yislenierm/vehicle-eme-ecu/base-project/6 - Documentation _ Calculators/Efficiency Curve/Efficiency Curve Test.jpg

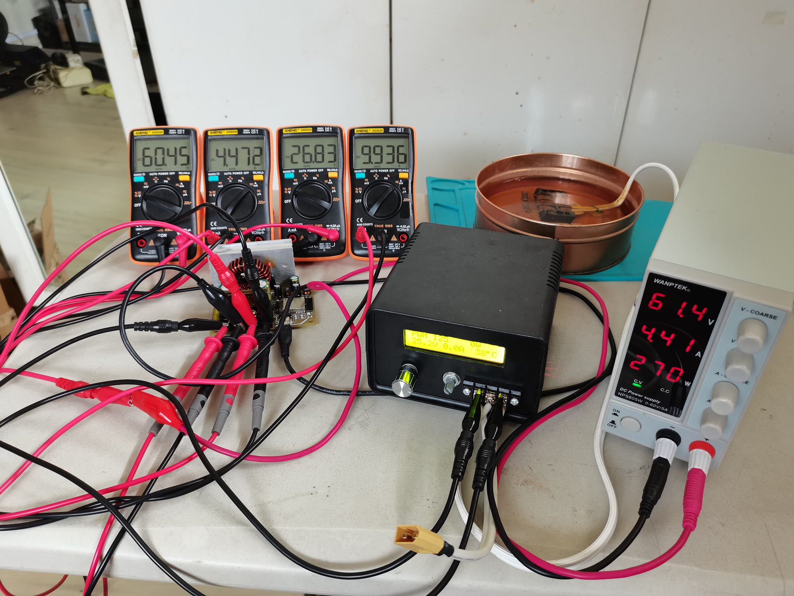
base-project/6 - Documentation _ Calculators/Efficiency Curve/Efficiency Curve Test.jpg
