yislenierm/vehicle-eme-ecu/README.md

# vehicle-eme-ecu
Vehicle/Boat Energy Management ECU

https://docs.google.com/document/d/18eBDC30Tg80u4Z4UTiznlT_HdNhbJPOtIIfXVYvO1t4/edit
