yislenierm/vehicle-eme-ecu/base-project/3 - Arduino ESP32 Code (Firmware)/Arduino Libraries/Read Me.txt

Copy, paste and replace the library folder with the attatched library folder on your Arduino IDE's System folder. 
Contact me at casithebuilder@gmail.com for concerns. Thank you!
