yislenierm/vehicle-eme-ecu/base-project/6 - Documentation _ Calculators/Reading Resources/ADS1115.docx

ADS1115

BIT VS. FREQUENCY LIMIT

8 bit - 31.25 kHz

9 bit - 15.625 kHz

10 bit - 78.125 kHz

11 bit - 39.0625 kHz

12 bit - 19.53125 kHz

ADC VALUES:

16 bit ADC - 65536
