yislenierm/vehicle-eme-ecu/base-project/6 - Documentation _ Calculators/Reading Resources/MPPT V3.docx

MPPT V3.0

BLYNK APP CONFIG

LABEL NAME | ITEM | BLYNK PIN | DESCRIPTION
SOLAR POWER (W) | GUAGE | V1
BATTERY PERCENTAGE (%) | GUAGE | V2
VOLTAGE (SOLAR) | LABELED VALUE | V3
CURRENT (SOLAR) | LABELED VALUE | V4
VOLTAGE (BATTERY) | LABELED VALUE | V5
CURRENT (BATTERY) | LABELED VALUE | V6
TEMPERATURE | LABELED VALUE | V7
ENERGY (KWH) | LABELED VALUE | V8
ENERGY SAVINGS (PESO) | LABELED VALUE | V9
CHG | LED | V10
FULL | LED | V11
ACT | LED | V12
FAULT | LED | V13
