yislenierm/vehicle-eme-ecu/base-project/1 - Schematic Files/2 - Button Breakout Board Schematic.png

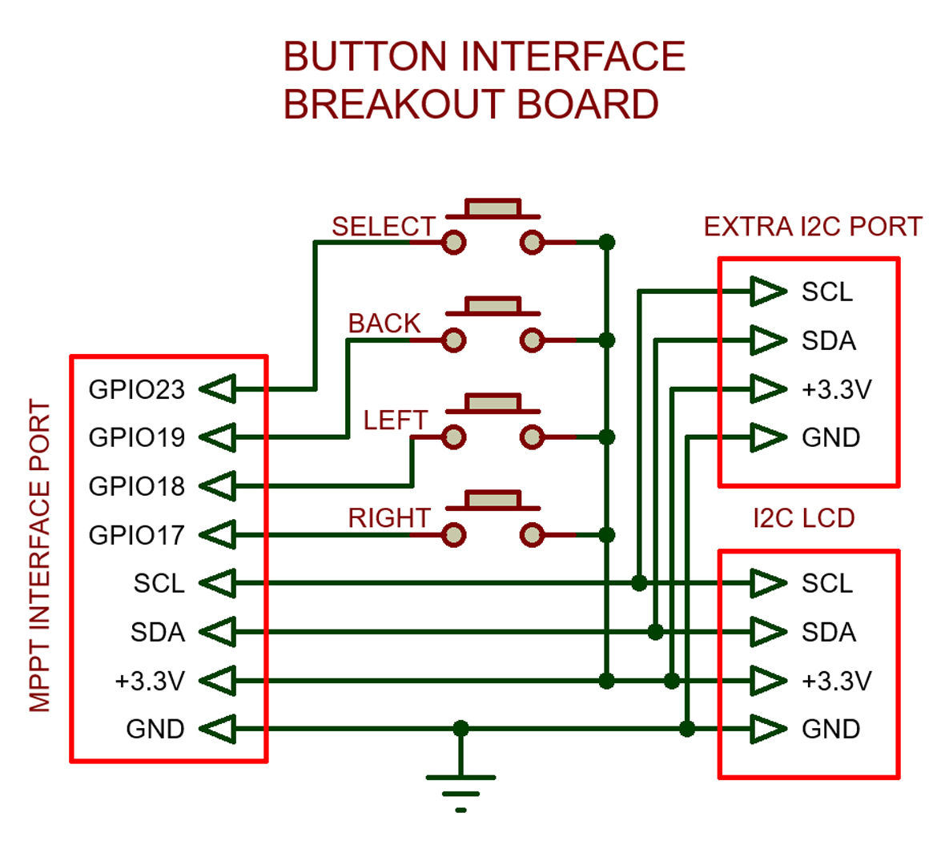
base-project/1 - Schematic Files/2 - Button Breakout Board Schematic.png
