yislenierm/vehicle-eme-ecu/base-project/1 - Schematic Files/3 - Two Pin Fan Breakout Board Schematic.png

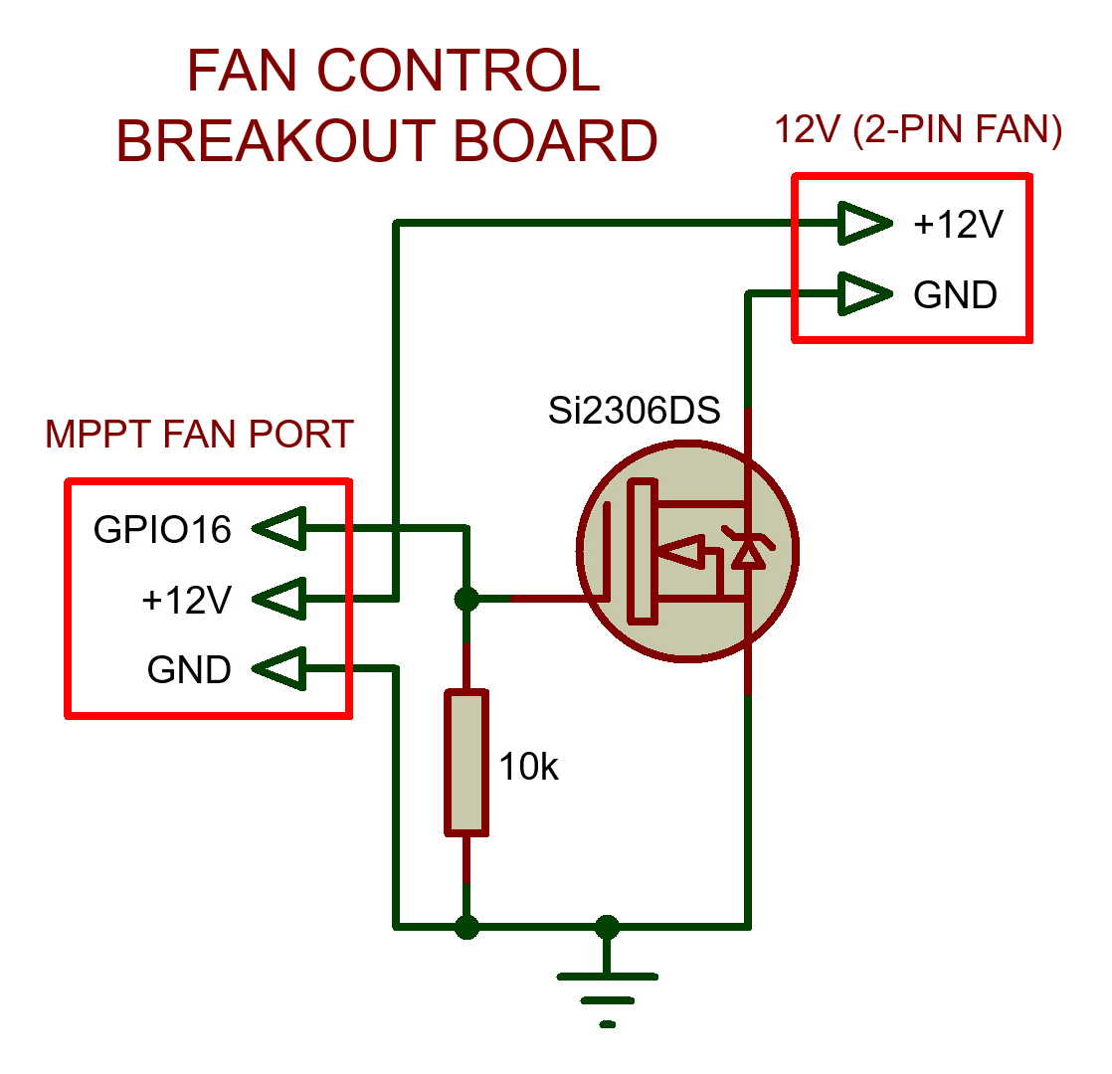
base-project/1 - Schematic Files/3 - Two Pin Fan Breakout Board Schematic.png
