yislenierm/vehicle-eme-ecu/base-project/6 - Documentation _ Calculators/Reading Resources/BACKFLOW GOLDEN SOLUTION.png

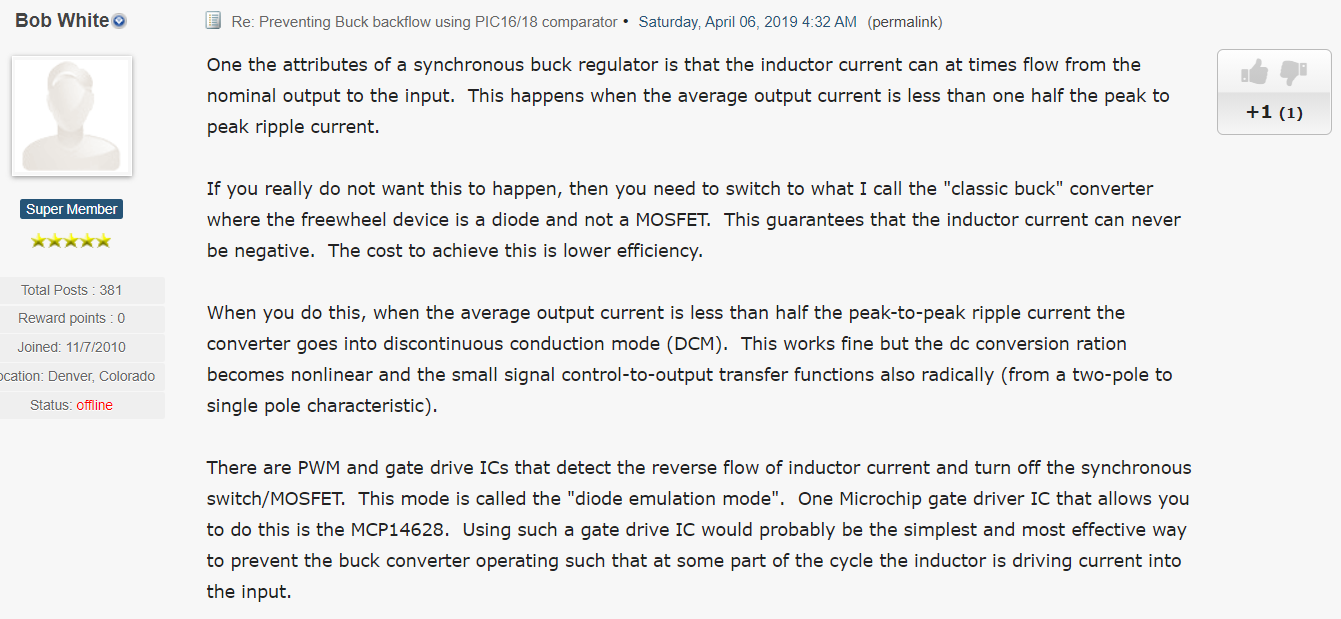
base-project/6 - Documentation _ Calculators/Reading Resources/BACKFLOW GOLDEN SOLUTION.png
