yislenierm/vehicle-eme-ecu/base-project/8 - Datasheets/Other References/INDUCTOR CORE - 0077071A7.jpg

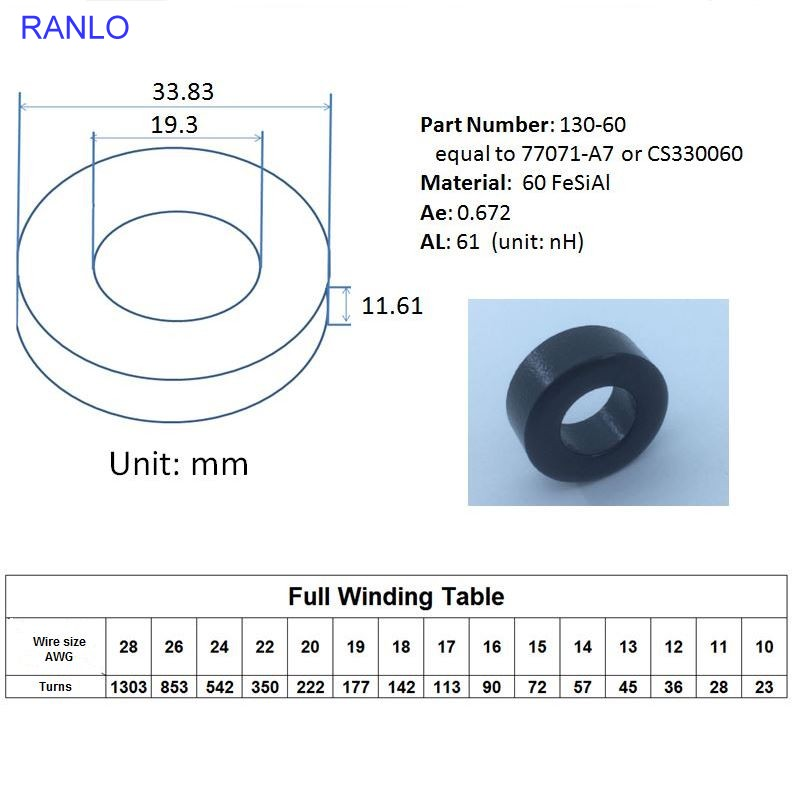
base-project/8 - Datasheets/Other References/INDUCTOR CORE - 0077071A7.jpg
