yislenierm/vehicle-eme-ecu/base-project/2 - PCB Files/Parts List.xlsx

PART# | TYPE | VALUE | SPECS | PACKAGE | Brand | DESCRIPTION | Cheapest Price (PHP) | Cheapest Price (USD) | Link (Where I Bought) | Link (Global) | Link (LCSC) | Link (RS Components) | Link (Digikey) | Link (Mouser)
Q1 | N-Channel MOSFET | CSD19505 | 80V, 208A, 2.6mΩ | TO220 | Texas Instruments |  | 15.3 | 0.306 | https://shopee.ph/10pcs-lot-CSD19505KCS-CSD19505-19505KCS-TO-220-80V-150A-new-original-In-Stock-i.409886423.4893377977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 | ! | ! | ! | ! | !
Q2 | N-Channel MOSFET | CSD19505 | 80V, 208A, 2.6mΩ | TO220 | Texas Instruments |  | 15.3 | 0.306 | https://shopee.ph/10pcs-lot-CSD19505KCS-CSD19505-19505KCS-TO-220-80V-150A-new-original-In-Stock-i.409886423.4893377977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 | ! | ! | ! | ! | !
Q3 | N-Channel MOSFET | CSD19505 | 80V, 208A, 2.6mΩ | TO220 | Texas Instruments |  | 15.3 | 0.306 | https://shopee.ph/10pcs-lot-CSD19505KCS-CSD19505-19505KCS-TO-220-80V-150A-new-original-In-Stock-i.409886423.4893377977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 | ! | ! | ! | ! | !
Q4 | N-Channel MOSFET | Si2306DS (A6SHB) | 30V, 2.8A, 94mΩ | SOT23 | Vishay |  | 1.66 | 0.0332 | https://shopee.ph/50pcs-SI2306DS-SOT23-SI2306-MOSFET-30V-4.0A-0.75W-New-fast-delivery-i.208678236.3724446730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 | ! | ! | ! | ! | !
Q5 | NPN Transistor | MMBT3904 (AM1) | 40V, 200mA | SOT23 | ON Semi |  | 0.47 | 0.0094 | https://shopee.ph/100PCS-MMBT3904-2N3904-3904-SMD-TRANSISTOR-NPN-40V-200mA-i.208678236.5324084618?position=0 | ! | ! | ! | ! | !
Q6 | NPN Transistor | MMBT3904 (AM1) | 40V, 200mA | SOT23 | ON Semi |  | 0.47 | 0.0094 | https://shopee.ph/100PCS-MMBT3904-2N3904-3904-SMD-TRANSISTOR-NPN-40V-200mA-i.208678236.5324084618?position=0 | ! | ! | ! | ! | !
D1 | Schottky Diode | SS310 | 100V, 3A | DO214 | TSC |  | 0.91 | 0.0182 | https://shopee.ph/100pcs-lot-SS310-SR3100-SMD-SR310-Schottky-Barrier-Rectifier-Diode-3A-100V-DO-214AC-SMA-GREAT-IT-In-Stock-i.357785223.5578885384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 | ! | ! | ! | ! | !
D2 | Schottky Diode | SS310 | 100V, 3A | DO214 | TSC |  | 0.91 | 0.0182 | https://shopee.ph/100pcs-lot-SS310-SR3100-SMD-SR310-Schottky-Barrier-Rectifier-Diode-3A-100V-DO-214AC-SMA-GREAT-IT-In-Stock-i.357785223.5578885384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 | ! | ! | ! | ! | !
D3 | Schottky Diode | SS310 | 100V, 3A | DO214 | TSC |  | 0.91 | 0.0182 | https://shopee.ph/100pcs-lot-SS310-SR3100-SMD-SR310-Schottky-Barrier-Rectifier-Diode-3A-100V-DO-214AC-SMA-GREAT-IT-In-Stock-i.357785223.5578885384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 | ! | ! | ! | ! | !
D4 | Rectifier Diode | M7 (1N4007) | 1000V, 1A | DO214 | TSC | SS310 can be used as alternative | 0.48 | 0.0096 | https://shopee.ph/100pcs-lot-1N4007-IN4007-SMD-1A-1000V-M7-Rectifier-Diode-In-Stock-i.358770500.7169716399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 | ! | ! | ! | ! | !
D5 | Schottky Diode | SS310 | 100V, 3A | DO214 | TSC |  | 0.91 | 0.0182 | https://shopee.ph/100pcs-lot-SS310-SR3100-SMD-SR310-Schottky-Barrier-Rectifier-Diode-3A-100V-DO-214AC-SMA-GREAT-IT-In-Stock-i.357785223.5578885384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 | ! | ! | ! | ! | !
D6 | Schottky Diode | SS310 | 100V, 3A | DO214 | TSC |  | 0.91 | 0.0182 | https://shopee.ph/100pcs-lot-SS310-SR3100-SMD-SR310-Schottky-Barrier-Rectifier-Diode-3A-100V-DO-214AC-SMA-GREAT-IT-In-Stock-i.357785223.5578885384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 | ! | ! | ! | ! | !
D7 | Schottky Diode | SS310 | 100V, 3A | DO214 | TSC |  | 0.91 | 0.0182 | https://shopee.ph/100pcs-lot-SS310-SR3100-SMD-SR310-Schottky-Barrier-Rectifier-Diode-3A-100V-DO-214AC-SMA-GREAT-IT-In-Stock-i.357785223.5578885384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 | ! | ! | ! | ! | !
D8 | Rectifier Diode | M7 (1N4007) | 1000V, 1A | DO214 | TSC | SS310 can be used as alternative | 0.48 | 0.0096 | https://shopee.ph/100pcs-lot-1N4007-IN4007-SMD-1A-1000V-M7-Rectifier-Diode-In-Stock-i.358770500.7169716399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 | ! | ! | ! | ! | !
U1 | Current Sensor | ACS712-30A | 30A Isolated Bidirectional | SO8 | Allegro |  | 64 | 1.28 | https://shopee.ph/5A-20A-30A-ACS712-Hall-Current-Sensor-Module-For-Arduino-i.309610120.7275310248?position=3 | ! | ! | ! | ! | !
U2 | DC-DC Isolator | B1212S | 12V to 12V Isolator | Special | EVSUN |  | 134 | 2.68 | https://shopee.ph/5pcs-lot-B1212S-1W-B1212-B1212S-SIP4-New-original-i.208678236.10038246654?position=4 | ! | ! | ! | ! | !
U3 | Linear Regulator (LDO) | AMS1117-5.0 | 5V, 1A | SOT223 | A.M.S. |  | 1.36 | 0.0272 | https://shopee.ph/50pcs-lot-AMS1117-5.0-LM1117-SOT-223-5V-Linear-Regulator-In-Stock-i.358770500.9103983681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 | ! | ! | ! | ! | !
U4 | Linear Regulator (LDO) | AMS1117-3.3 | 3.3V, 1A | SOT223 | A.M.S. |  | 4.3 | 0.086 | https://shopee.ph/10pcs-lot-AMS1117-3.3V-AMS1117-3.3-AMS1117-LM1117-1117-SOT-223-new-original-In-Stock-i.409886423.10815166260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 | ! | ! | ! | ! | !
U5 | Buck Converter | XL7005A | 80V, 0.4A Buck | SO8P | XL Semi |  | 12.6 | 0.252 | https://shopee.ph/10pcs-XL7005A-perfect-alternative-XL7005E1-XL7005-SOP8-automotive-IC-Chip-i.262012177.6543571459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 | ! | ! | ! | ! | !
U6 | Buck Converter | XL7005A | 80V, 0.4A Buck | SO8P | XL Semi |  | 12.6 | 0.252 | https://shopee.ph/10pcs-XL7005A-perfect-alternative-XL7005E1-XL7005-SOP8-automotive-IC-Chip-i.262012177.6543571459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 | ! | ! | ! | ! | !
U7 | MOSFET Driver | IR2104 | 520ns Deadtime | SO8 | Infineon |  | 9.3 | 0.186 | https://shopee.ph/10pcs-lot-IR2104STRPBF-IR2104SPBF-IR2104-IR2104S-SOP-8-new-original-In-Stock-i.358770500.8568967671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 | ! | ! | ! | ! | !
U8 | MCU | ESP32 | 32-bit, 240MHz, Dual Core | Special | Espressif/ WROOM |  | 135 | 2.7 | https://shopee.ph/ESP-32S-ESP-WROOM-32-ESP32-ESP-32-Bluetooth-y-WIFI-CPU-de-doble-n%C3%BAcleo-con-bajo-consumo-de-energ%C3%ADa-MCU-ESP-32-i.375468409.95612685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 | ! | ! | ! | ! | !
U9 | USB To Serial UART | CH340G/ CH340C | USB 2.0, 2MBPS | SO8 | WCH |  | 16.6 | 0.332 | https://shopee.ph/10pcs-lot-CH340C-CH340-SOP-16-IC-best-quality-In-Stock-i.358770500.9703983887?position=2 | ! | ! | ! | ! | !
U10 | ADC | ADS1115 | 16-Bit I2C ADC | SOP10 | Texas Instruments |  | 152 | 3.04 | https://shopee.ph/ADS1115-16-bit-Analog-to-Digital-Converter-Module-i.237034143.7750821160?position=1 | ! | ! | ! | ! | !
X1 | Crystal Resonator | 12MHz | 12MHz Resonator | SMD | Generic | Only needed for CH340G variant (CH340C does not need one) | 0 | 0 | - | ! | ! | ! | ! | !
F1 | Automotive DC Fuse | 35A | Mini Size | THT | Generic |  | 4.7 | 0.094 | https://shopee.ph/(COD)-10pcs-Car-fuse-plug-fuse-motorcycle-fuse-boat-fuse-1-micro-mini-standard-plug-fuse-i.212420707.6261291722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 | ! | ! | ! | ! | !
F2 | Automotive DC Fuse | 35A | Mini Size | THT | Generic |  | 4.7 | 0.094 | https://shopee.ph/(COD)-10pcs-Car-fuse-plug-fuse-motorcycle-fuse-boat-fuse-1-micro-mini-standard-plug-fuse-i.212420707.6261291722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 | ! | ! | ! | ! | !
L1 | Inductor | 64uH | 36A (DIY) | THT | Generic |  | 0 | 0 | - | ! | ! | ! | ! | !
L2 | Inductor | 100uH | 0.5A | SMD | Generic |  | 16 | 0.32 | https://www.e-gizmo.net/oc/index.php?route=product/product&product_id=48976&search=100uh+smd&description=true | ! | ! | ! | ! | !
L3 | Inductor | 100uH | 0.5A | SMD | Generic |  | 16 | 0.32 | https://www.e-gizmo.net/oc/index.php?route=product/product&product_id=48976&search=100uh+smd&description=true | ! | ! | ! | ! | !
LED1 | LED Indicator | - | - | _0805 | Generic |  | 0.74 | 0.0148 | https://shopee.ph/100pcs-0402-0603-0805-1206-smd-led-Red-Yellow-Green-White-Blue-Orange-light-emitting-diode-Water-Clear-LED-Light-Diode-Set-i.313430978.40576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 | ! | ! | ! | ! | !
LED2 | LED Indicator | - | - | _0805 | Generic |  | 0.74 | 0.0148 | https://shopee.ph/100pcs-0402-0603-0805-1206-smd-led-Red-Yellow-Green-White-Blue-Orange-light-emitting-diode-Water-Clear-LED-Light-Diode-Set-i.313430978.40576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 | ! | ! | ! | ! | !
C1 | Ceramic Capacitor | 100nF |  | _0805 | Generic |  | 2 | 0.04 | https://www.e-gizmo.net/oc/index.php?route=product/category&path=75_175_232 | ! | ! | ! | ! | !
C2 | Ceramic Capacitor | 2.2uF |  | 1206 | Generic |  | 2 | 0.04 | https://www.e-gizmo.net/oc/index.php?route=product/category&path=75_175_235 | ! | ! | ! | ! | !
C3 | Ceramic Capacitor | 100nF |  | _0805 | Generic |  | 2 | 0.04 | https://www.e-gizmo.net/oc/index.php?route=product/category&path=75_175_232 | ! | ! | ! | ! | !
C4 | Ceramic Capacitor | 100nF |  | _0805 | Generic |  | 2 | 0.04 | https://www.e-gizmo.net/oc/index.php?route=product/category&path=75_175_232 | ! | ! | ! | ! | !
C5 | Ceramic Capacitor | 4.7uF |  | 1206 | Generic |  | 2 | 0.04 | https://www.e-gizmo.net/oc/index.php?route=product/category&path=75_175_235 | ! | ! | ! | ! | !
C6 | Ceramic Capacitor | 4.7uF |  | 1206 | Generic |  | 2 | 0.04 | https://www.e-gizmo.net/oc/index.php?route=product/category&path=75_175_235 | ! | ! | ! | ! | !
C7 | Electrolytic Capacitor | 470uF / 100V |  | THT | Generic |  | 30 | 0.6 | https://www.e-gizmo.net/oc/index.php?route=product/category&path=75_172_248 | ! | ! | ! | ! | !
C8 | Electrolytic Capacitor | 470uF / 100V |  | THT | Generic |  | 30 | 0.6 | https://www.e-gizmo.net/oc/index.php?route=product/category&path=75_172_248 | ! | ! | ! | ! | !
C9 | Ceramic Capacitor | 2.2uF |  | _0805 | Generic |  | 2 | 0.04 | https://www.e-gizmo.net/oc/index.php?route=product/category&path=75_175_232 | ! | ! | ! | ! | !
C10 | Ceramic Capacitor | 4.7uF |  | 1206 | Generic |  | 2 | 0.04 | https://www.e-gizmo.net/oc/index.php?route=product/category&path=75_175_235 | ! | ! | ! | ! | !
C11 | Ceramic Capacitor | 100nF |  | _0805 | Generic |  | 2 | 0.04 | https://www.e-gizmo.net/oc/index.php?route=product/category&path=75_175_232 | ! | ! | ! | ! | !
C12 | Ceramic Capacitor | 100nF |  | _0805 | Generic |  | 2 | 0.04 | https://www.e-gizmo.net/oc/index.php?route=product/category&path=75_175_232 | ! | ! | ! | ! | !
C13 | Ceramic Capacitor | 100nF |  | _0805 | Generic |  | 2 | 0.04 | https://www.e-gizmo.net/oc/index.php?route=product/category&path=75_175_232 | ! | ! | ! | ! | !
C14 | Electrolytic Capacitor | 100uF/16V |  | THT | Generic |  | 4 | 0.08 | https://www.e-gizmo.net/oc/index.php?route=product/category&path=75_172_248 | ! | ! | ! | ! | !
C15 | Ceramic Capacitor | 33nF |  | _0805 | Generic |  | 2 | 0.04 | https://www.e-gizmo.net/oc/index.php?route=product/category&path=75_175_232 | ! | ! | ! | ! | !
C16 | Electrolytic Capacitor | 100uF/16V |  | THT | Generic |  | 4 | 0.08 | https://www.e-gizmo.net/oc/index.php?route=product/category&path=75_172_248 | ! | ! | ! | ! | !
C17 | Ceramic Capacitor | 33nF |  | _0805 | Generic |  | 2 | 0.04 | https://www.e-gizmo.net/oc/index.php?route=product/category&path=75_175_232 | ! | ! | ! | ! | !
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
R21 | Resistor | 10k |  | _0805 | Generic |  | 0.25 | 0.005 | https://www.e-gizmo.net/oc/index.php?route=product/category&path=75_169_255 | ! | ! | ! | ! | !
R22 | Resistor | 10k |  | _0805 | Generic |  | 0.25 | 0.005 | https://www.e-gizmo.net/oc/index.php?route=product/category&path=75_169_255 | ! | ! | ! | ! | !
R23 | Resistor | 10k |  | _0805 | Generic |  | 0.25 | 0.005 | https://www.e-gizmo.net/oc/index.php?route=product/category&path=75_169_255 | ! | ! | ! | ! | !
R24 | Resistor | 10k |  | _0805 | Generic |  | 0.25 | 0.005 | https://www.e-gizmo.net/oc/index.php?route=product/category&path=75_169_255 | ! | ! | ! | ! | !
R25 | Resistor | 10k |  | _0805 | Generic |  | 0.25 | 0.005 | https://www.e-gizmo.net/oc/index.php?route=product/category&path=75_169_255 | ! | ! | ! | ! | !
R26 | Resistor | 10k |  | _0805 | Generic |  | 0.25 | 0.005 | https://www.e-gizmo.net/oc/index.php?route=product/category&path=75_169_255 | ! | ! | ! | ! | !
R27 | Resistor | 10k |  | _0805 | Generic |  | 0.25 | 0.005 | https://www.e-gizmo.net/oc/index.php?route=product/category&path=75_169_255 | ! | ! | ! | ! | !
R28 | Resistor | 10k |  | _0805 | Generic |  | 0.25 | 0.005 | https://www.e-gizmo.net/oc/index.php?route=product/category&path=75_169_255 | ! | ! | ! | ! | !
R29 | Resistor | 10k |  | _0805 | Generic |  | 0.25 | 0.005 | https://www.e-gizmo.net/oc/index.php?route=product/category&path=75_169_255 | ! | ! | ! | ! | !
R30 | Resistor | 10k |  | _0805 | Generic |  | 0.25 | 0.005 | https://www.e-gizmo.net/oc/index.php?route=product/category&path=75_169_255 | ! | ! | ! | ! | !
R31 | Resistor | 10k |  | _0805 | Generic |  | 0.25 | 0.005 | https://www.e-gizmo.net/oc/index.php?route=product/category&path=75_169_255 | ! | ! | ! | ! | !
R32 | Resistor | 47k |  | _0805 | Generic |  | 0.25 | 0.005 | https://www.e-gizmo.net/oc/index.php?route=product/category&path=75_169_255 | ! | ! | ! | ! | !
R33 | Resistor | 47k |  | _0805 | Generic |  | 0.25 | 0.005 | https://www.e-gizmo.net/oc/index.php?route=product/category&path=75_169_255 | ! | ! | ! | ! | !
R34 | Resistor | 1k |  | _0805 | Generic |  | 0.25 | 0.005 | https://www.e-gizmo.net/oc/index.php?route=product/category&path=75_169_255 | ! | ! | ! | ! | !
R35 | NTC Thermistor | 10k |  | THT | Generic | 10K @ 25C NTC Thermistor | 42 | 0.84 | https://www.e-gizmo.net/oc/index.php?product_id=49493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 | ! | ! | ! | ! | !
R36 | Resistor | 10k |  | _0805 | Generic |  | 0.25 | 0.005 | https://www.e-gizmo.net/oc/index.php?route=product/category&path=75_169_255 | ! | ! | ! | ! | !
R37 | Resistor | 10k |  | _0805 | Generic |  | 0.25 | 0.005 | https://www.e-gizmo.net/oc/index.php?route=product/category&path=75_169_255 | ! | ! | ! | ! | !
USB1 | MINI USB Port | Generic |  | SMD | Generic |  | 2.95 | 0.059 | https://shopee.ph/MOONPH-20-pcs-Mini-USB-Type-B-Female-Port-5-Pin-180-Degree-SMD-SMT-PCB-Jack-i.131640010.5807023279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 | ! | ! | ! | ! | !
MISC. | Toroidal Core | 0077071A7 (TRC02) |  | - | Magnetics Inc. |  | 25 | 0.5 | https://www.e-gizmo.net/oc/index.php?route=product/product&product_id=47991&search=trc-02&description=true | ! | ! | ! | ! | !
MISC. | AWG 16 Wire | Generic |  | - | Generic |  | 24 | 0.48 | https://shopee.ph/MAGNET-WIRE-PER-METER-REWINDING-SIZE-12-13-14-15-16-17-18-19-20-21-22-23-24-25-MAGNETIC-COPPER-i.158252840.9919092098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 | ! | ! | ! | ! | !
MISC. | Heatsink | EHS01 |  | - | Generic | Aluminum Heatsink 69x40.5x15mm | 45 | 0.9 | https://www.e-gizmo.net/oc/index.php?route=product/product&product_id=791&search=ehs+1&description=true&page=2 | ! | ! | ! | ! | !
MISC. | LCD | I2C 16X2 Character |  |  | E-Gizmo | for MPPT & button breakout board (optional) | 112 | 2.24 | https://shopee.ph/16x2-LCD-Display-I2C-White-on-Blue-i.18252381.242465767?position=0 | ! | ! | ! | ! | !
MISC. | Tact Buttons | 2 pin |  |  | Generic | for button breakout board | 2 | 0.04 | https://shopee.ph/5pcs-Push-Button-Tact-Switch-Momentary-ON-SPST-Through-Hole-col-i.237034143.7841483103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 | ! | ! | ! | ! | !
MISC. | Tact Buttons | 2 pin |  |  | Generic | for button breakout board | 2 | 0.04 | https://shopee.ph/5pcs-Push-Button-Tact-Switch-Momentary-ON-SPST-Through-Hole-col-i.237034143.7841483103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 | ! | ! | ! | ! | !
MISC. | Tact Buttons | 2 pin |  |  | Generic | for button breakout board | 2 | 0.04 | https://shopee.ph/5pcs-Push-Button-Tact-Switch-Momentary-ON-SPST-Through-Hole-col-i.237034143.7841483103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 | ! | ! | ! | ! | !
MISC. | Tact Buttons | 2 pin |  |  | Generic | for button breakout board | 2 | 0.04 | https://shopee.ph/5pcs-Push-Button-Tact-Switch-Momentary-ON-SPST-Through-Hole-col-i.237034143.7841483103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 | ! | ! | ! | ! | !
MISC. | N-Channel MOSFET | Si2306DS (A6SHB) | 30V, 2.8A, 94mΩ | SOT23 | Vishay | for 2 pin fan converter breakout board | 1.66 | 0.0332 | https://shopee.ph/50pcs-SI2306DS-SOT23-SI2306-MOSFET-30V-4.0A-0.75W-New-fast-delivery-i.208678236.3724446730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 | ! | ! | ! | ! | !
MISC. | Screw Terminal | 4 Pin 50A
 |  |  |  |  |  | TOTAL: (PHP - Philippine Currency) | 1033.17 | PHP | Philippine Currency
 |  |  |  |  |  | TOTAL: (USD - American Currency) | 20.6634 | USD | American Currency
