yislenierm/vehicle-eme-ecu/base-project/6 - Documentation _ Calculators/MPPT Design Calculator/TechBuilder - MPPT CALCULATOR.xlsx

Sheet: MPPT BUCK DESIGN CALCULATOR
MPPT: SYNCHRONOUS BUCK DESIGN CALCULATOR
REQUIRED PARAMETERS | VALUE | UNIT | NOTES
Vmp | 64.4 | V | Solar panel maximum powerpoint voltage (found in solar panel back sticker)
Imp | 9.98 | A | Solar panel maximum powerpoint current (found in solar panel back sticker)
Vbatt | 27 | V | Maximum battery voltage of your setup
fsw | 39 | kHz | MPPT buck converter pwm switching frequency (Visit Sheet #2)
ASSUMED PARAMETERS | VALUE | UNIT | NOTES
Vripple | 0.05 | V | MPPT output ripple voltage (50mV is a good and ideal value)
%Iripple | 35 | %
%efficiency | 100 | % | MPPT buck conversion efficiency (use 100% for ideal computation, 96% for actual computation)
SOLVED PARAMETERS | VALUE | UNIT | NOTES
Solar Power (Psolar) | 642.712 | W | The maximum solar panel power output
Duty Cycle (D) | 41.92546584 | % | The PWM duty cycle % at given parameter conditions
Ripple Current (dl) | 8.331451852 | A | Maximum continous current for MOSFET
Peak Inductor Current (Ipk) | 27.96987407 | A | Maximum current rating for inductor (selected inductor must have a higher saturation current)
Inductance (L) | 48.25743153 | uH | Inductance for your MPPT's synchronous buck inductor (select nearest value)
Output Capacitor (Cout) | 534.0674264 | uF | Capacitance of your MPPT's output capacitor to achieve a ripple voltage less than or equal to Vripple (select any value above it)
KINDLY DOWNLOAD THE EXCEL FILE THEN EDIT IT LOCALLY! I WON'T BE SENDING GOOGLE PERMISSIONS TO EDIT THIS FILE HERE

Sheet: SWITCHING FREQUENCY GUIDE
ESP32: PWM RESOLUTION & PWM FREQUENCY TABLE
Resolution (Bits) | Resolution (decimal) | Max PWM Frequency (kHz)
1 | 2 | 40000
2 | 4 | 20000
3 | 8 | 10000
4 | 16 | 5000
5 | 32 | 2500
6 | 64 | 1250
7 | 128 | 625
8 | 256 | 312.5
9 | 512 | 156.25
10 | 1024 | 78.125
11 | 2048 | 39.0625
12 | 4096 | 19.53125
13 | 8192 | 9.765625
14 | 16384 | 4.8828125
15 | 32768 | 2.44140625
16 | 65536 | 1.220703125

Sheet: ACS712-30A THEORETICAL RESPONSE
CALIBRATION PARAMETERS |  | CALIBRATION PARAMETERS
VCC (V) | 5 | VCC (V) | 5
VMIDPOINT (V) | 2.5 | VMIDPOINT (V) | 2.5
Sensitivity (mV/A) | 66 | Sensitivity (mV/A) | 66
ACS712-30A (Current & Vo Relationship) |  | ACS712-30A (Current & Vo Relationship)
Current (A) | Analog Out (V) | Current (A) | Analog Out (V)
-35 | 0.19 | -35 | 0.19
-34 | 0.256 | -30 | 0.52
-33 | 0.322 | -25 | 0.85
-32 | 0.388 | -20 | 1.18
-31 | 0.454 | -15 | 1.51
-30 | 0.52 | -10 | 1.84
-29 | 0.586 | -5 | 2.17
-28 | 0.652 | 0 | 2.5
-27 | 0.718 | 5 | 2.83
-26 | 0.784 | 10 | 3.16
-25 | 0.85 | 15 | 3.49
-24 | 0.916 | 20 | 3.82
-23 | 0.982 | 25 | 4.15
-22 | 1.048 | 30 | 4.48
-21 | 1.114 | 35 | 4.81
-20 | 1.18
-19 | 1.246
-18 | 1.312
-17 | 1.378
-16 | 1.444
-15 | 1.51
-14 | 1.576
-13 | 1.642
-12 | 1.708
-11 | 1.774
-10 | 1.84
-9 | 1.906
-8 | 1.972
-7 | 2.038
-6 | 2.104
-5 | 2.17
-4 | 2.236
-3 | 2.302
-2 | 2.368
-1 | 2.434
0 | 2.5
1 | 2.566
2 | 2.632
3 | 2.698
4 | 2.764
5 | 2.83
6 | 2.896
7 | 2.962
8 | 3.028
9 | 3.094
10 | 3.16
11 | 3.226
12 | 3.292
13 | 3.358
14 | 3.424
15 | 3.49
16 | 3.556
17 | 3.622
18 | 3.688
19 | 3.754
20 | 3.82
21 | 3.886
22 | 3.952
23 | 4.018
24 | 4.084
25 | 4.15
26 | 4.216
27 | 4.282
28 | 4.348
29 | 4.414
30 | 4.48
31 | 4.546
32 | 4.612
33 | 4.678
34 | 4.744
35 | 4.81
