yislenierm/vehicle-eme-ecu/base-project/6 - Documentation _ Calculators/Toroidal Inductor Design Calculator/Inductor Calculator.xlsx

Sheet: Toroid Calculator #1
Toroidal Inductor Calculator
 |  |  | NOTES:
 |  |  | - Use this calculator if your toroidal core's datasheet specifies AL & Ae. (Gives much more accurate results)
 |  |  | - Parameters OD, ID, H, μr, Bsat, AL & Ae are often provided in datasheets.
 |  |  | - OD, ID, H are the toroid's physical dimensions that can be measured using a ruler or caliper. (better get from datasheet)
 |  |  | - Bsat depends on your toroidal core's material. Some datasheets may not specify this directly. A separate excel sheet tab
 |  |  | guide is provided under. It contains all the Bsat for common toroidal core materials.
 |  |  | - AL depends on your toroidal core's material. While this can be computed, datasheets often provide this parameter as the
 |  |  | computation method may not be accurate.
 |  |  | - Ae depends on your toroidal core's dimensions. This can be computed as well, but datasheets often provide this parameter
 |  |  | since dimensions OD, ID and H includes materials that are not included in an toroidal core's effective cross-sectional area.
 |  |  | - If AL and Ae are not specified on the datasheet, kindly use "Toroidal Calculator #2" found under the excel sheet tabs under.
 |  |  | The second calculator uses formulas to estimate both parameters. I highly discourage this as it is not as accurate as calc #1
 |  |  | - The "Computation Results" section shows the N number of turns of wire around your inductor to achieve L, the specified
 |  |  | inductor design inductance value. LW is the predicted wire length needed to achieve the number of turns around the inductor.
 |  |  | Lw is just a suggestive value, be sure to cut the magnet wire slightly longer than Lw to account for the leads and winding gaps.
 |  |  | Isat on the other hand is simply your inductor's current rating.
Parameter | Input Box | Units | Description | PARAMETER TYPE
L | 64 | uH | Inductance - Input the desired toroidal inductor's inductancd in (μH - microhenry) | Designer Parameter
d | 16 | AWG | Wire Guage - Magnet wire's thickness (optional for wire length prediction) | Designer Parameter
OD | 33.5 | mm | Toroid's Outer Diameter - Input toroidal core's outer ring diameter | Core Dimension
ID | 19.5 | mm | Toroid's Inner Diameter - Input toroidal core's inner ring diameter | Core Dimension
H | 11 | mm | Toroid's Height - Input toroidal core's height or thickness | Core Dimension
μr | 60 | μ | Toroid's Relative Magnetic Permeability | Core Material
Bsat | 1 | T | Toroid's Magnetic Saturation Flux Density | Core Material
AL | 61 | nH/N2 | Toroid's Inductance Factor | Core Material
Ae | 65.6 | mm2 | Toroid's Effective Cross Sectional Area | Core Dimension
Computation Results (Needed For Inductor Building)
Isat | 33.20082954 | A | Inudctor Saturation Current - Inductor's current rating | Computed Parameter
N | 29.93310885 | - | Turns - Required wire turns around the toroid to get the specified inductance rating | Computed Parameter
Lw | 1.154869981 | m | Wire Length - Predicted length of wire you'll need (be sure to cut a slightly longer length) | Computed Parameter

Sheet: Toroidal Calculator #2
Toroidal Inductor Calculator
 |  |  | NOTES:
Parameter | Input Box | Units | Description | PARAMETER TYPE
L | 64 | uH | Inductance - Input the desired toroidal inductor's inductancd in (μH - microhenry) | Designer Parameter
d | 16 | AWG | Wire Diameter - Magnet wire's diameter (optional for wire length prediction) | Designer Parameter
OD | 33.5 | mm | Toroid's Outer Diameter - Input toroidal core's outer ring diameter | Core Dimension
ID | 19.5 | mm | Toroid's Inner Diameter - Input toroidal core's inner ring diameter | Core Dimension
H | 11 | mm | Toroid's Height - Input toroidal core's height or thickness | Core Dimension
μr | 60 | μ | Toroid's Relative Magnetic Permeability | Core Material
Bsat | 1 | T | Toroid's Magnetic Saturation Flux Density | Core Material
Computation Results (not needed for inductor building)
AL | 71.42928847 | nH/N2 | Toroid's Inductance Factor | Core Material
Ae | 77 | mm2 | Toroid's Effective Cross Sectional Area | Core Dimension
Computation Results (Needed for inductor building)
Isat | 36.01327159 | A | Inudctor Saturation Current - Inductor's current rating | Computed Parameter
N | 29.93310885 | - | Turns - Required wire turns around the toroid to get the specified inductance rating | Computed Parameter
Lw | 1.154869981 | m | Wire Length - Predicted length of wire you'll need (be sure to cut a slightly longer length) | Computed Parameter
