yislenierm/vehicle-eme-ecu/base-project/7 - 3D Printing Files/Enclosure (No LCD)/SOLIDWORKS (Editable)/Enclosure Body.SLDPRT

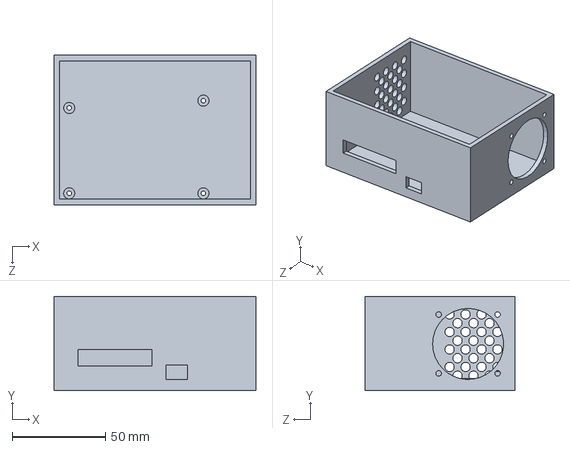
[picture p8: CAD file, 2022-08-12]
base-project/7 - 3D Printing Files/Enclosure (No LCD)/SOLIDWORKS (Editable)/Enclosure Body.SLDPRT
108.1 x 50.5 x 80.1 mm
