yislenierm/vehicle-eme-ecu/base-project/7 - 3D Printing Files/Enclosure (No LCD)/STL (3D Printing)/Buttons.STL

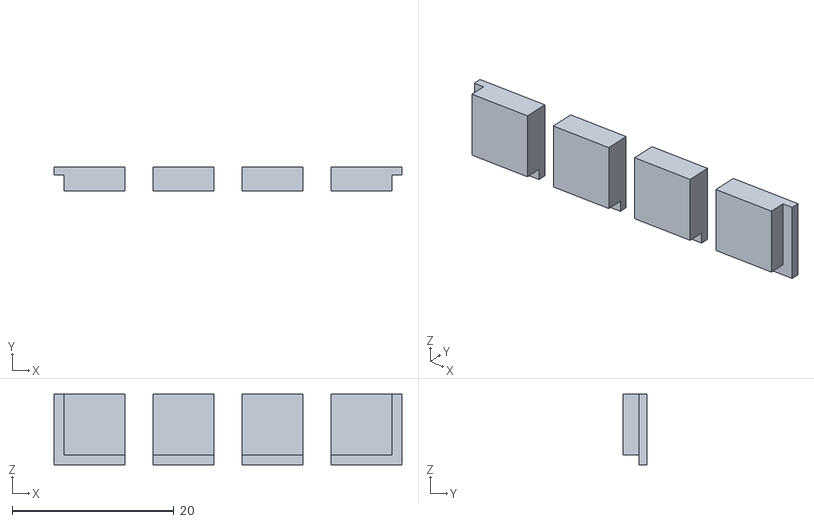
[picture p9: CAD file, 2022-08-12]
base-project/7 - 3D Printing Files/Enclosure (No LCD)/STL (3D Printing)/Buttons.STL
43.0 x 3.00 x 8.75
