yislenierm/vehicle-eme-ecu/base-project/7 - 3D Printing Files/Enclosure (With LCD And Buttons)/SOLIDWORKS (Editable)/Tact Buttons (Labeled).SLDPRT

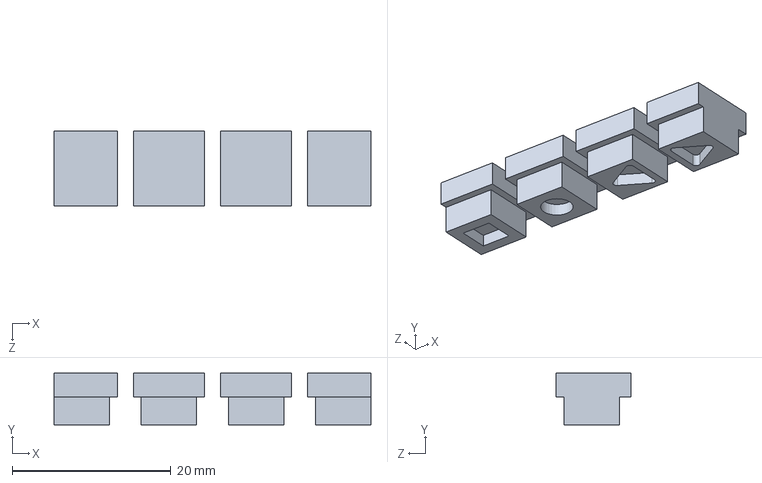
[picture p10: CAD file, 2022-08-12]
base-project/7 - 3D Printing Files/Enclosure (With LCD And Buttons)/SOLIDWORKS (Editable)/Tact Buttons (Labeled).SLDPRT
40.0 x 6.50 x 9.50 mm
