yislenierm/vehicle-eme-ecu/base-project/7 - 3D Printing Files/Enclosure (With LCD And Buttons)/STL (3D Printing)/Tact Buttons (Unlabeled).STL

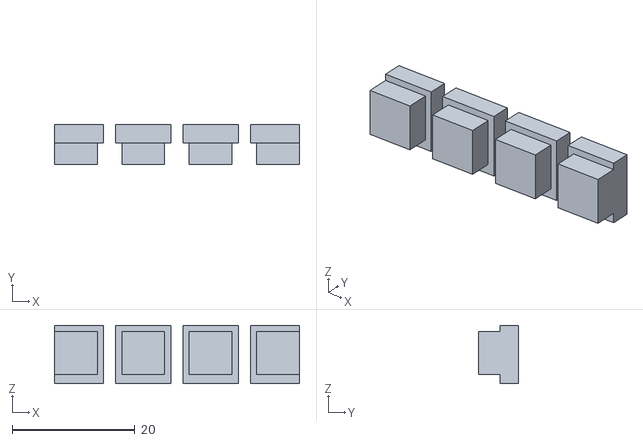
[picture p11: CAD file, 2022-08-12]
base-project/7 - 3D Printing Files/Enclosure (With LCD And Buttons)/STL (3D Printing)/Tact Buttons (Unlabeled).STL
40.0 x 6.50 x 9.50
