yislenierm/vehicle-eme-ecu/base-project/7 - 3D Printing Files/Enclosure (No LCD)/STL (3D Printing)/Enclosure Cover.STL

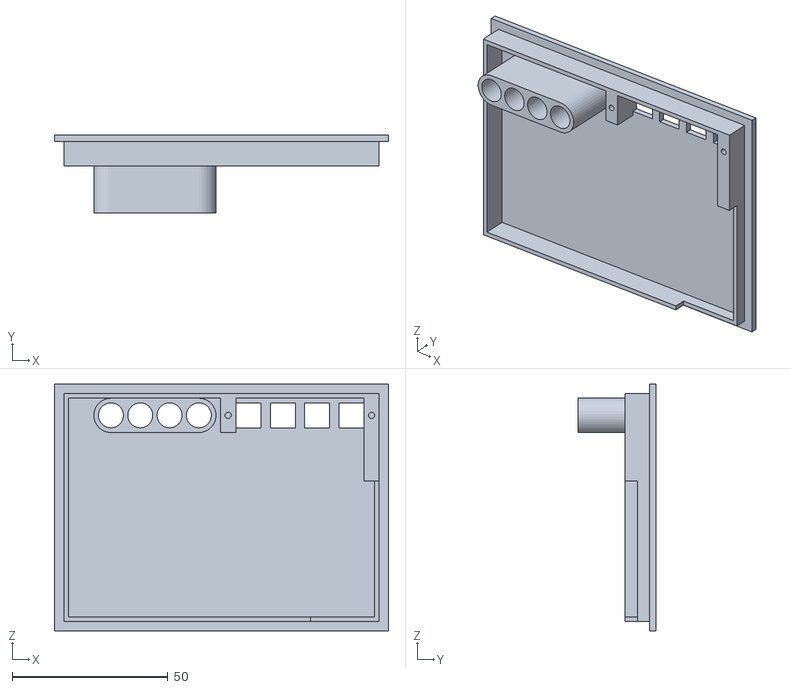
[picture p12: CAD file, 2022-08-12]
base-project/7 - 3D Printing Files/Enclosure (No LCD)/STL (3D Printing)/Enclosure Cover.STL
107.1 x 25.0 x 79.1
