yislenierm/vehicle-eme-ecu/base-project/7 - 3D Printing Files/Enclosure (With LCD And Buttons)/SOLIDWORKS (Editable)/Enclosure Body.SLDPRT

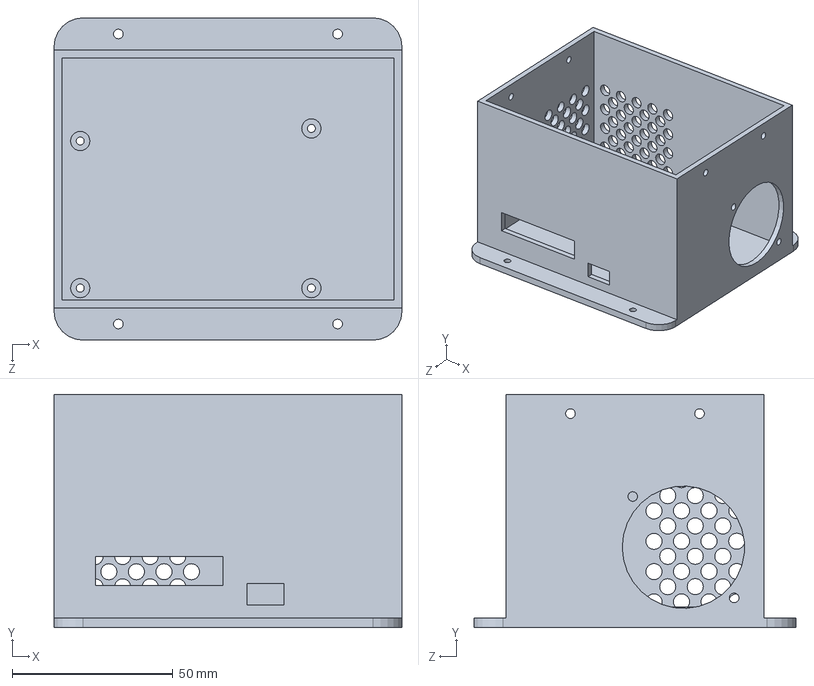
[picture p13: CAD file, 2022-08-12]
base-project/7 - 3D Printing Files/Enclosure (With LCD And Buttons)/SOLIDWORKS (Editable)/Enclosure Body.SLDPRT
108.1 x 72.5 x 100.1 mm
