yislenierm/vehicle-eme-ecu/base-project/7 - 3D Printing Files/Enclosure (With LCD And Buttons)/STL (3D Printing)/Enclosure Cover.STL

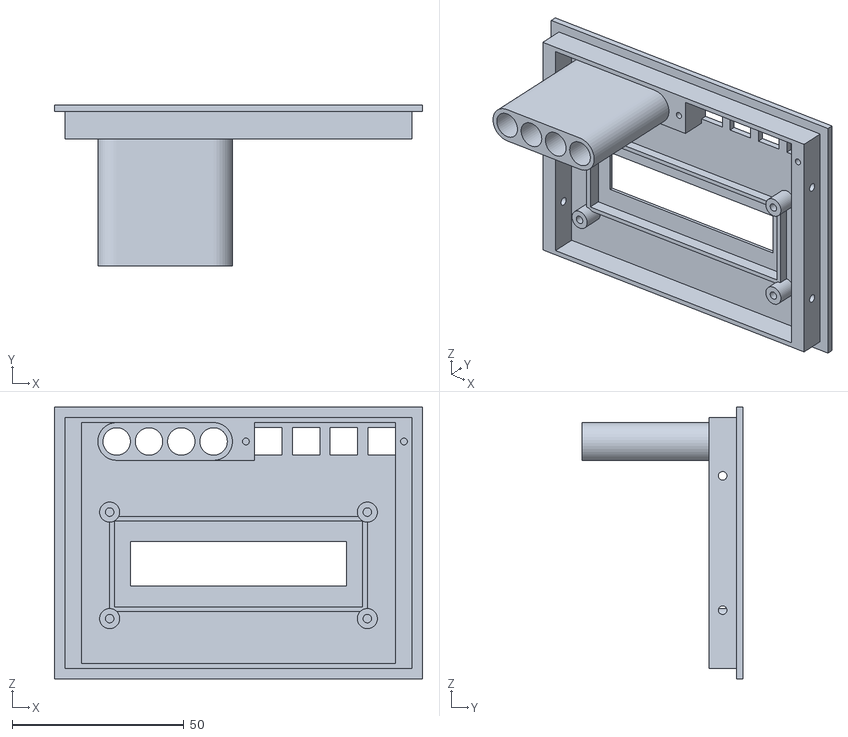
[picture p14: CAD file, 2022-08-12]
base-project/7 - 3D Printing Files/Enclosure (With LCD And Buttons)/STL (3D Printing)/Enclosure Cover.STL
107.1 x 47.0 x 79.1
