yislenierm/vehicle-eme-ecu/(list of files, cad)

Other CAD files:
base-project/7 - 3D Printing Files/Enclosure (No LCD)/SOLIDWORKS (Editable)/Buttons.SLDPRT
base-project/7 - 3D Printing Files/Enclosure (No LCD)/SOLIDWORKS (Editable)/Enclosure Cover.SLDPRT
base-project/7 - 3D Printing Files/Enclosure (No LCD)/STL (3D Printing)/Enclosure Body.STL
base-project/7 - 3D Printing Files/Enclosure (With LCD And Buttons)/SOLIDWORKS (Editable)/Enclosure Cover.SLDPRT
base-project/7 - 3D Printing Files/Enclosure (With LCD And Buttons)/STL (3D Printing)/Enclosure Body.STL
base-project/7 - 3D Printing Files/Enclosure (With LCD And Buttons)/SOLIDWORKS (Editable)/Tact Buttons (Unlabeled).SLDPRT
base-project/7 - 3D Printing Files/Enclosure (With LCD And Buttons)/STL (3D Printing)/Tact Buttons (Labeled).STL
