yislenierm/vehicle-eme-ecu/base-project/6 - Documentation _ Calculators/Efficiency Curve/Efficiency Curve Test.xlsx

Vin | Iin | Vout | Iout | Pin | Pout | % Eff
61.49 | 0 | 26.95 | 0 | 0 | 0 | 0
61.49 | 0.061 | 26.95 | 0.0245 | 3.75089 | 0.660275 | 17.60315552
61.45 | 0.2065 | 26.97 | 0.3542 | 12.689425 | 9.552774 | 75.281378
61.4 | 0.3889 | 26.95 | 0.7684 | 23.87846 | 20.70838 | 86.72410197
61.36 | 0.563 | 26.96 | 1.178 | 34.54568 | 31.75888 | 91.93300002
61.33 | 0.7134 | 26.94 | 1.503 | 43.752822 | 40.49082 | 92.54447633
61.29 | 0.8933 | 26.95 | 1.912 | 54.750357 | 51.5284 | 94.1151854
61.26 | 1.002 | 26.95 | 2.157 | 61.38252 | 58.13115 | 94.70310114
61.21 | 1.219 | 26.94 | 2.654 | 74.61499 | 71.49876 | 95.82358719
61.19 | 1.387 | 26.94 | 3.027 | 84.87053 | 81.54738 | 96.08444769
61.14 | 1.538 | 26.94 | 3.369 | 94.03332 | 90.76086 | 96.51989316
61.12 | 1.645 | 26.93 | 3.607 | 100.5424 | 97.13651 | 96.61248389
61.07 | 1.889 | 26.93 | 4.157 | 115.36123 | 111.94801 | 97.04127635
61.05 | 1.996 | 26.93 | 4.393 | 121.8558 | 118.30349 | 97.08482485
61.02 | 2.171 | 26.93 | 4.787 | 132.47442 | 128.91391 | 97.31230376
60.98 | 2.309 | 26.92 | 5.096 | 140.80282 | 137.18432 | 97.43009408
60.94 | 2.52 | 26.91 | 5.564 | 153.5688 | 149.72724 | 97.49847625
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
