yislenierm/vehicle-eme-ecu/(list of files, drawings)

Other design files:
base-project/2 - PCB Files/Proteus Files (Editable EDA Files)/1 - MPPT Board.pdsprj
base-project/2 - PCB Files/Proteus Files (Editable EDA Files)/2 - Button Breakout Board.pdsprj
base-project/2 - PCB Files/Proteus Files (Editable EDA Files)/3 - Two Pin Fan Breakout Board.pdsprj
