yislenierm/vehicle-eme-ecu/(commit log)

2022-08-12 Add base project
    [1 - MPPT Board.pdsprj, 2 - Button Breakout Board.pdsprj, 3 - Two Pin Fan Breakout Board.pdsprj, Buttons.SLDPRT, Buttons.STL, Efficiency Curve Test.xlsx, Enclosure Body.SLDPRT, Enclosure Body.STL]
2022-08-13 Added part list diodes
    [eme-ecu.kicad_sch]
